skagmo/anslut_heatpump/img/on-off.png

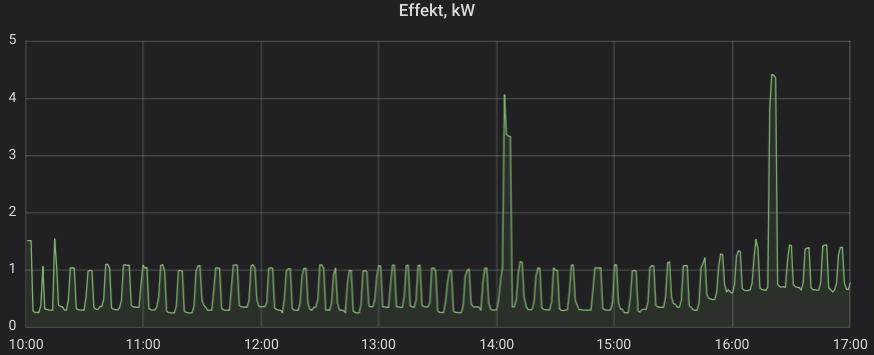
img/on-off.png
