skagmo/anslut_heatpump/iface_schematic.sch

## EAGLE design iface_schematic.sch (2018-10-28)

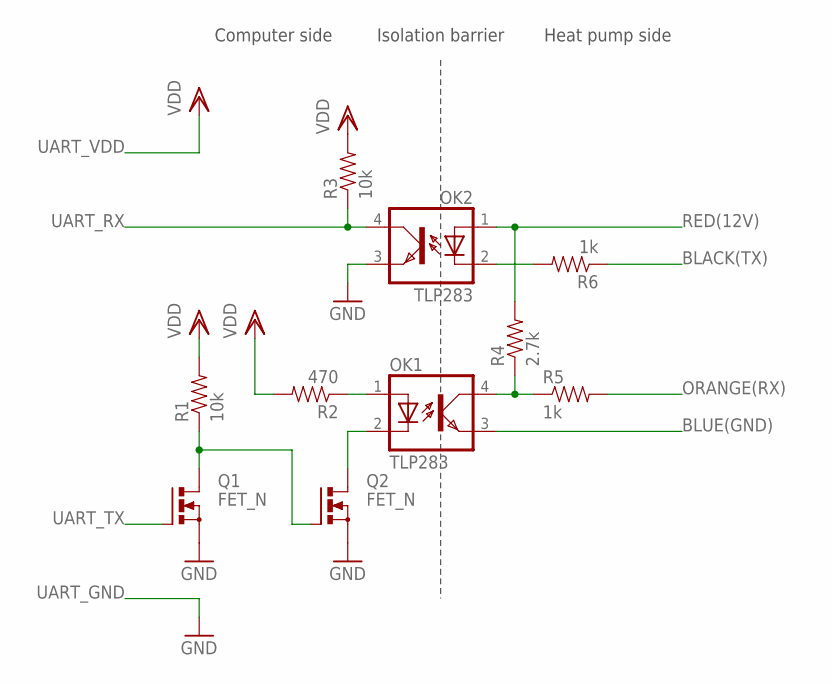
[picture p5: schematic iface_schematic.sch]

Parts:
OK1, OK2: TLP283; MINI-FLAT-4
Q1, Q2: FET_N; SOT23-3
R1, R3: 10k; 0603
R2: 470; 0603
R4: 2.7k; 0603
R5, R6: 1k; 0603

Connections:
BLACK(TX): R6.1
BLUE(GND): OK1.3 (EMIT)
GND: OK2.3 (EMIT), Q1.2 (S), Q2.2 (S)
unnamed: OK1.2 (C), Q2.3 (D)
unnamed: OK1.1 (A), R2.1
unnamed: Q1.3 (D), Q2.1 (G), R1.1
unnamed: OK1.4 (COL), R4.1, R5.1
unnamed: OK2.2 (C), R6.2
ORANGE(RX): R5.2
RED(12V): OK2.1 (A), R4.2
UART_RX: OK2.4 (COL), R3.1
UART_TX: Q1.1 (G)
VDD: R1.2, R2.2, R3.2

Notes on the sheet:
Isolation barrier
Computer side
Heat pump side
