skagmo/anslut_heatpump/(notices)

Notices in the files:
parts and their libraries:
04-sparkfun: Licensing: CC v3.0 Share-Alike You are welcome to use this library for commercial purposes.
